HELP-TEC/MQTT_Keypad/board/Datasheet/demo_board/ESP32-POE-ISO-GPIO.png

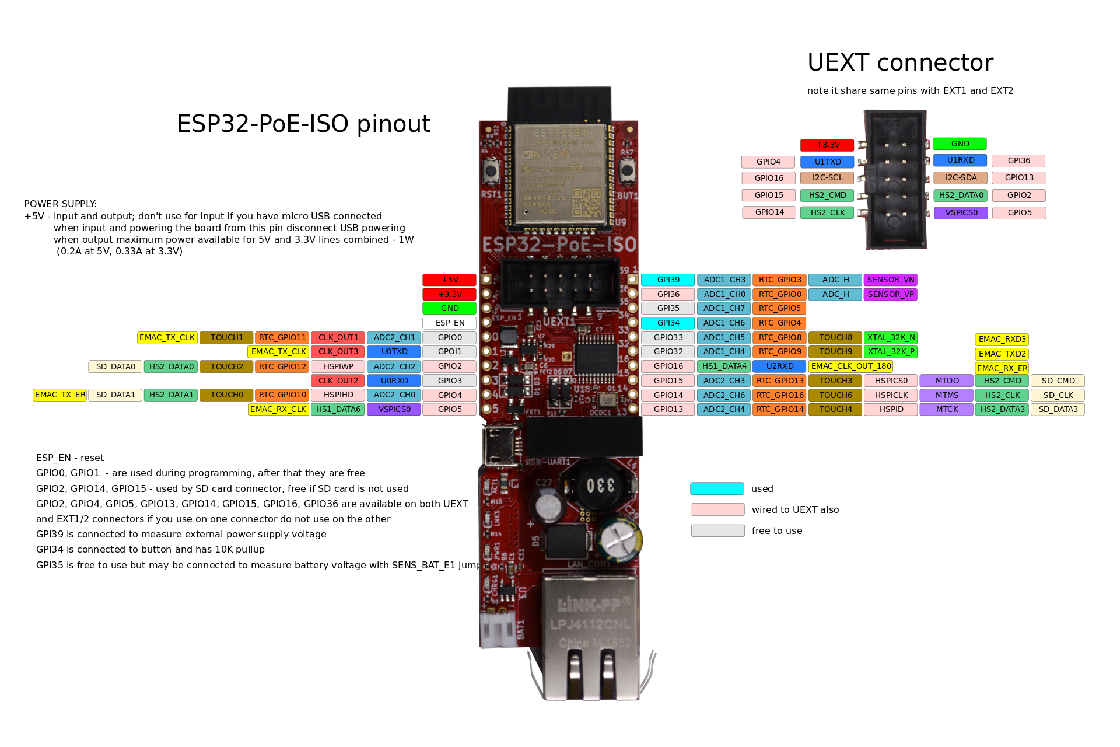
board/Datasheet/demo_board/ESP32-POE-ISO-GPIO.png
