HELP-TEC/MQTT_Keypad/README.md

# MQTT_Keypad
Keypad board using MQTT to transmit its signals

KiCAD  6.0.2 (version CERN Windows)
