HELP-TEC/MQTT_Keypad/Consception/Hardware.docx

Hes-so,HelpTec

Développement architecture Hardware

Document de spécification architecturale hardware générique niveaux d’abstraction élevé

Thibault Sampiemon

[Date]

# Architecture Carte de Gestion des Périphériques :

button

button

button

button

button

button

button

button

button

button

button

button

button

button

button

Ethernet

POE transformer

Ethernet connector

DC/DC converter

microcontroler

AC/DC adapter

potentiomètre

I/O schield

Bouttons

Bouttons

# Architecture Carte de Gestion des Périphériques :
