HELP-TEC/MQTT_Keypad/Consception/Doc1.docx

# SPI :

Le seul spi accessible facilement est le même que pour la carte mémoire.

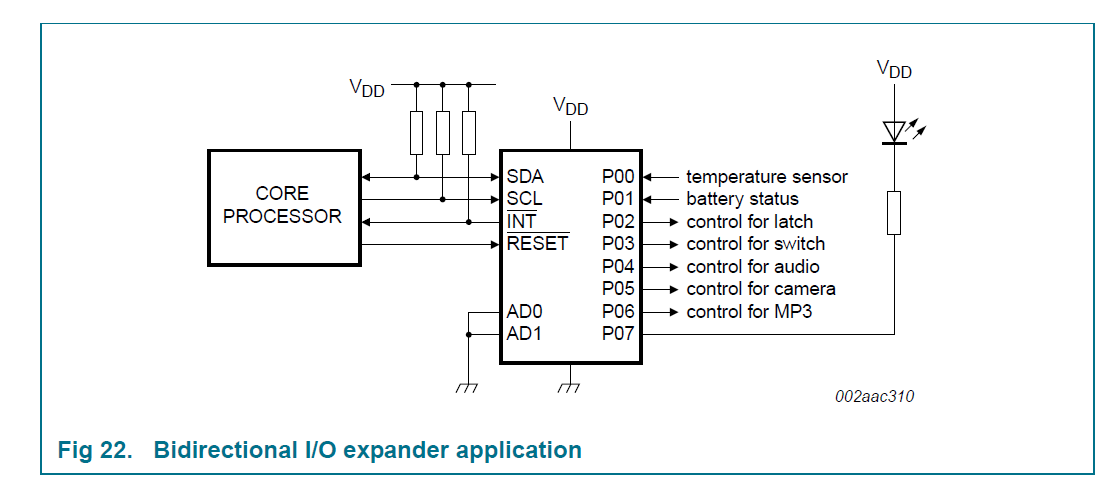
[picture p2: figure]
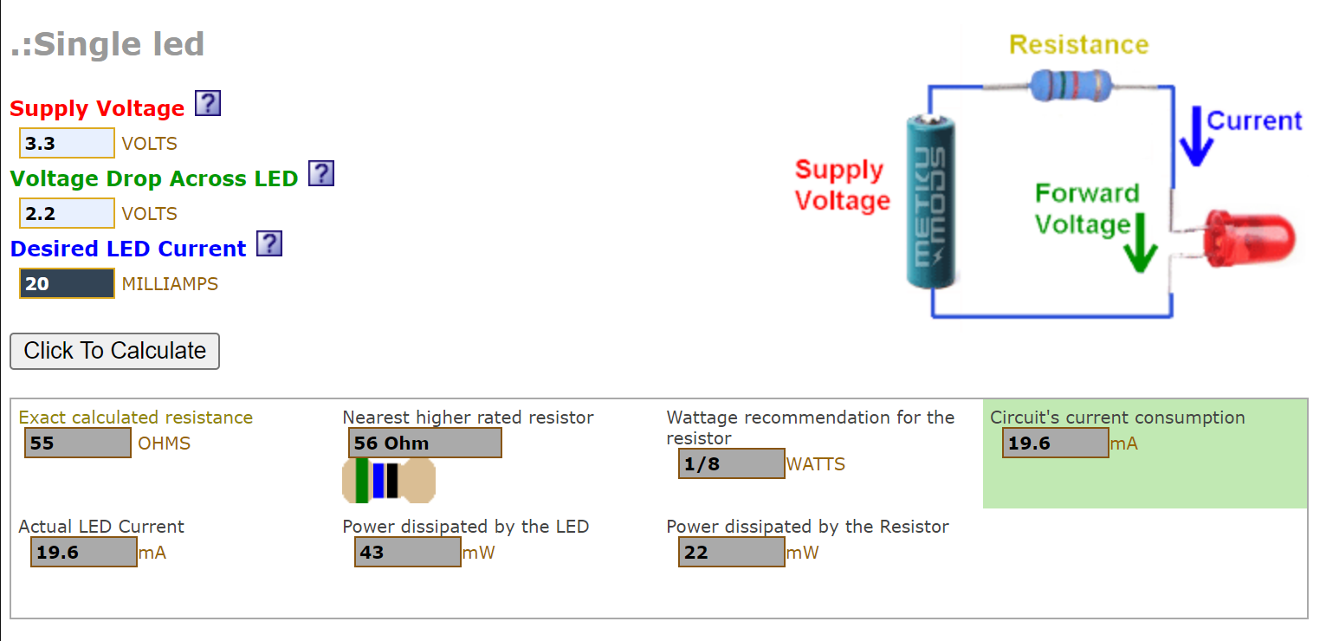
[picture p3: figure]
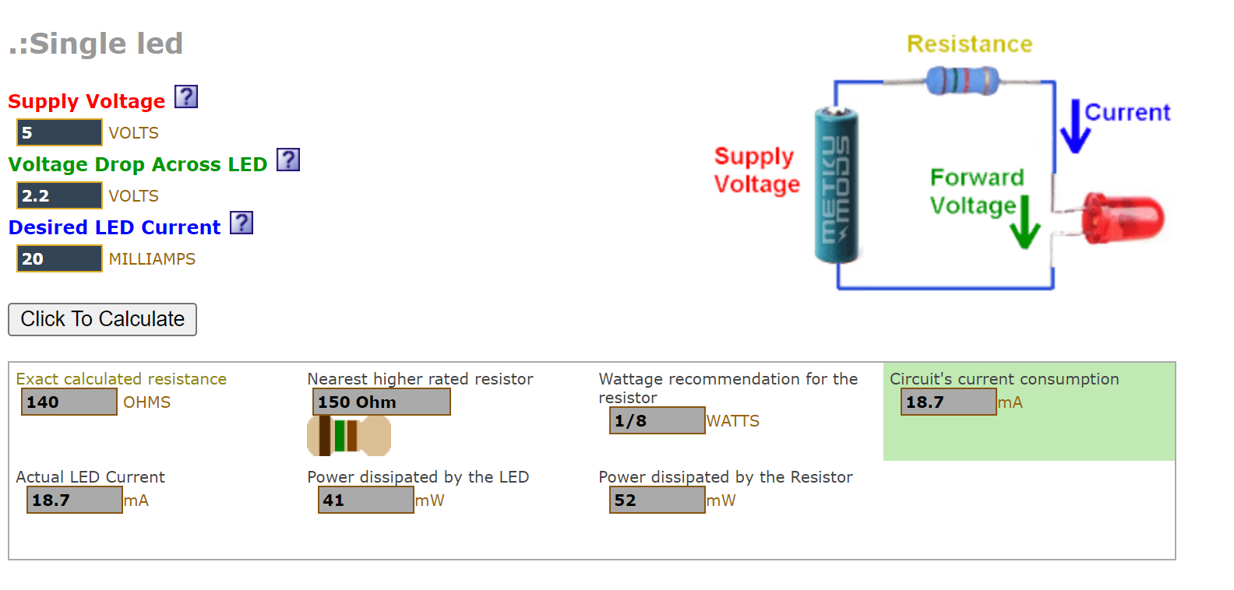
[picture p4: figure]
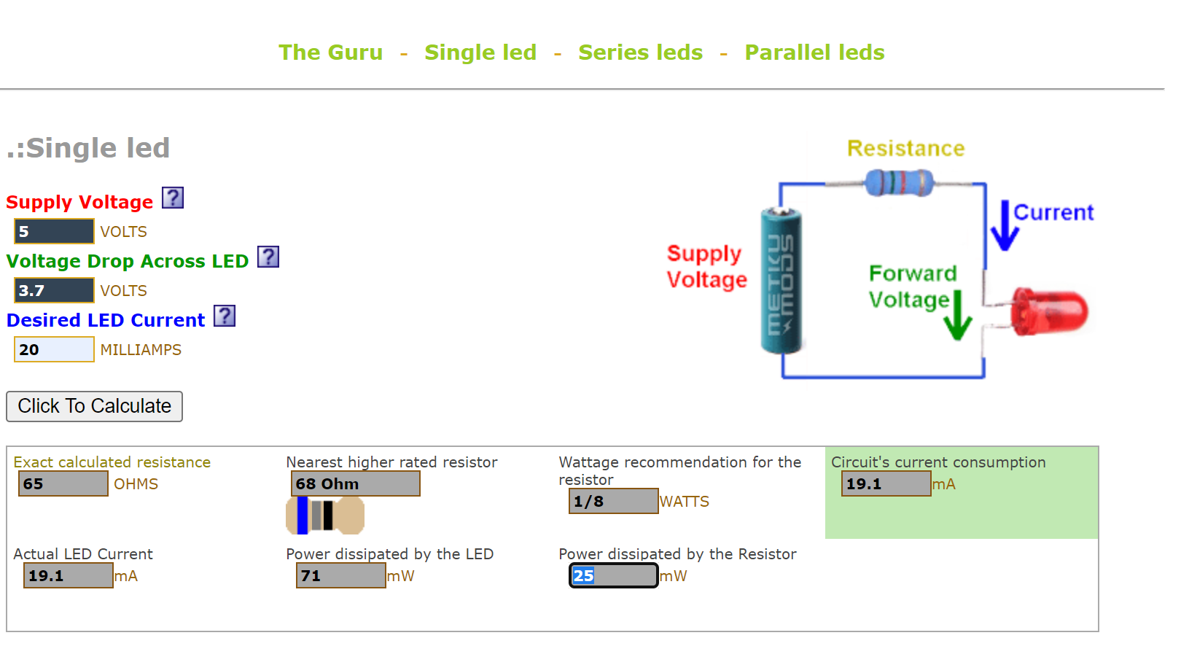
[picture p5: figure]
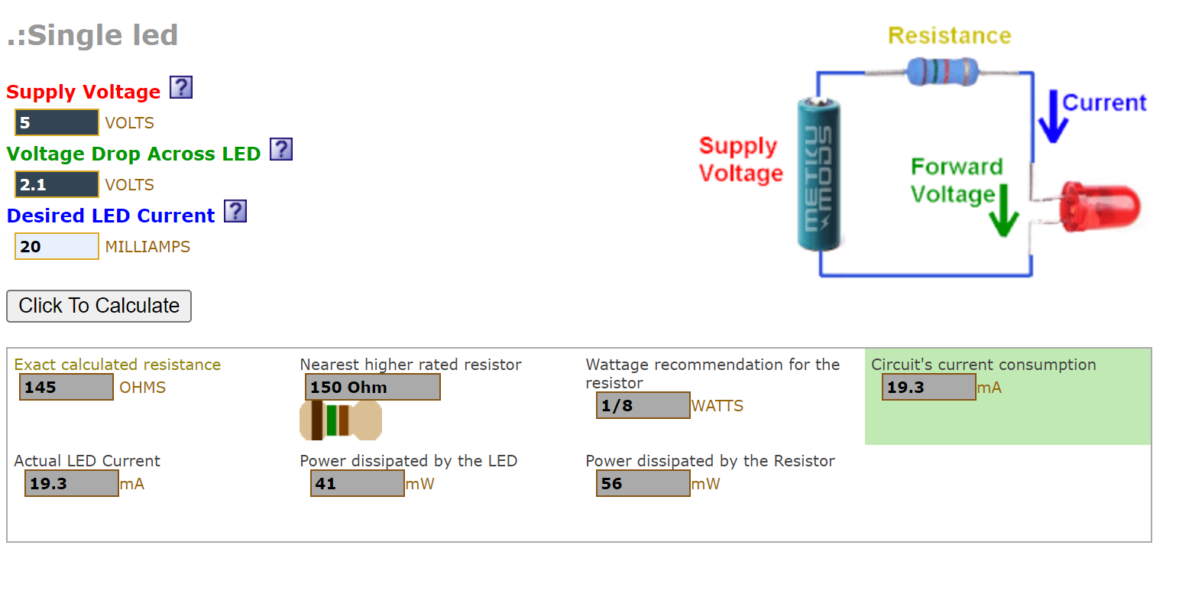
[picture p6: figure]
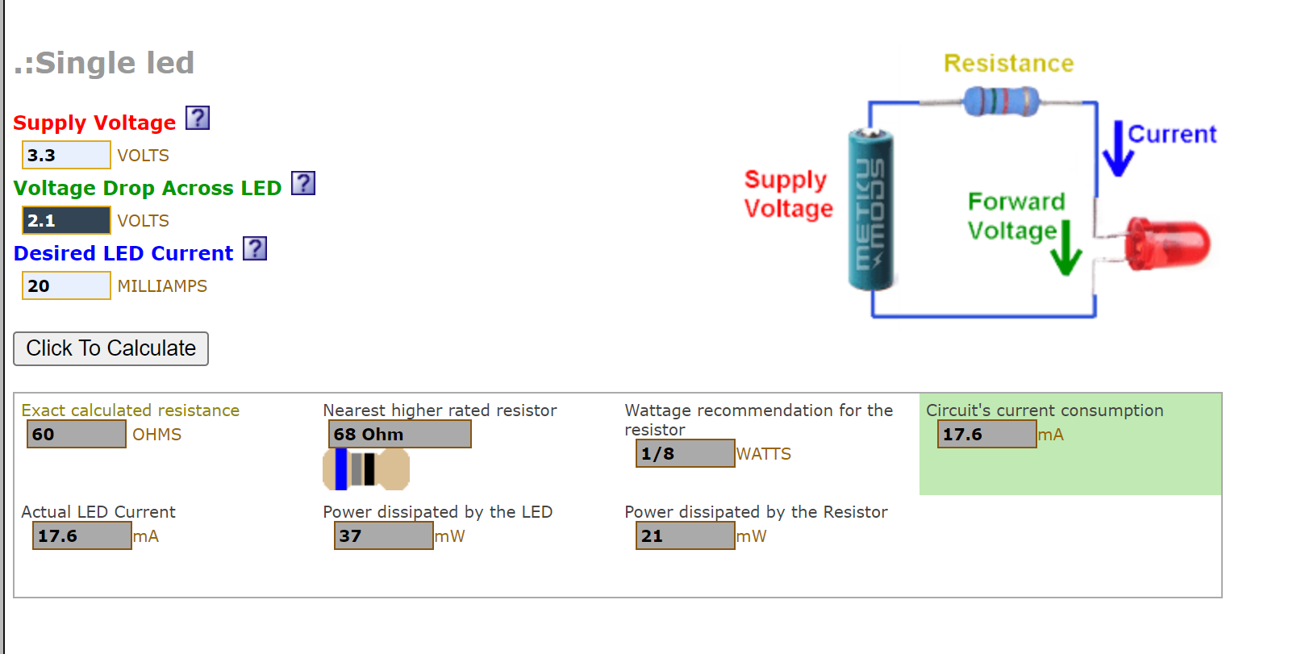
[picture p7: figure]
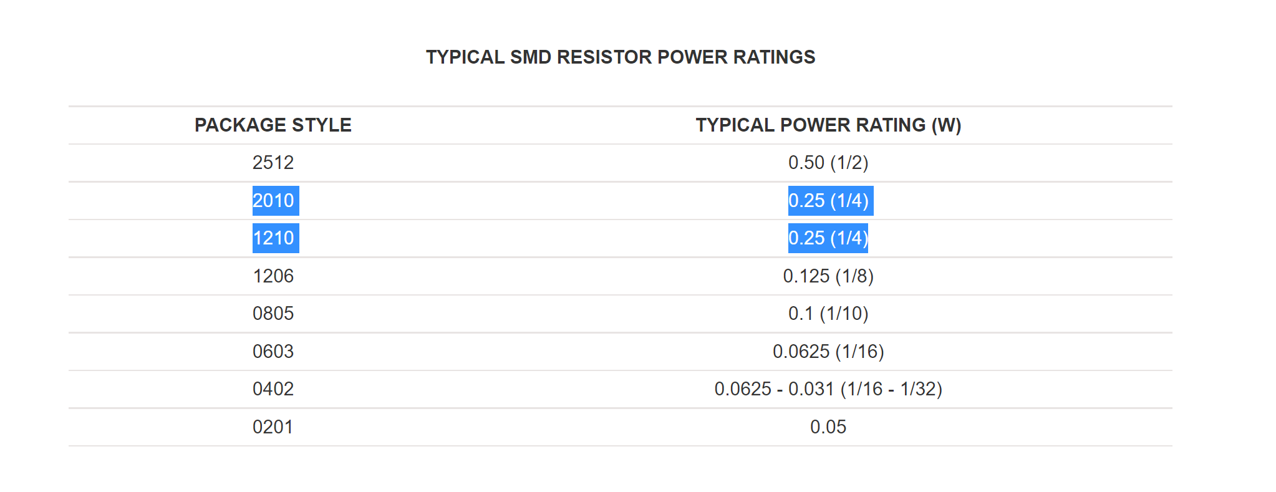
[picture p8: figure]
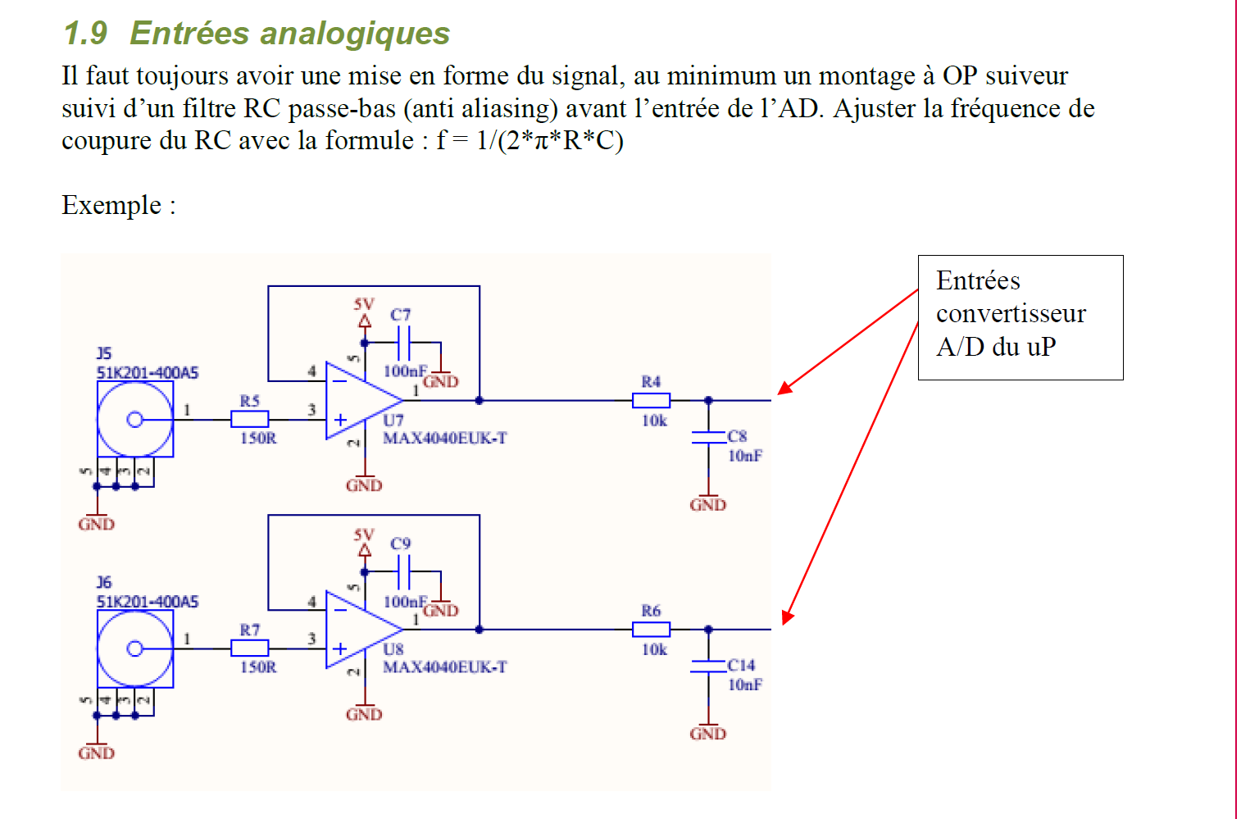
[picture p9: figure]

Avec 100 nf 1000hz (jamais de mesure plus fréquente que 1ms)

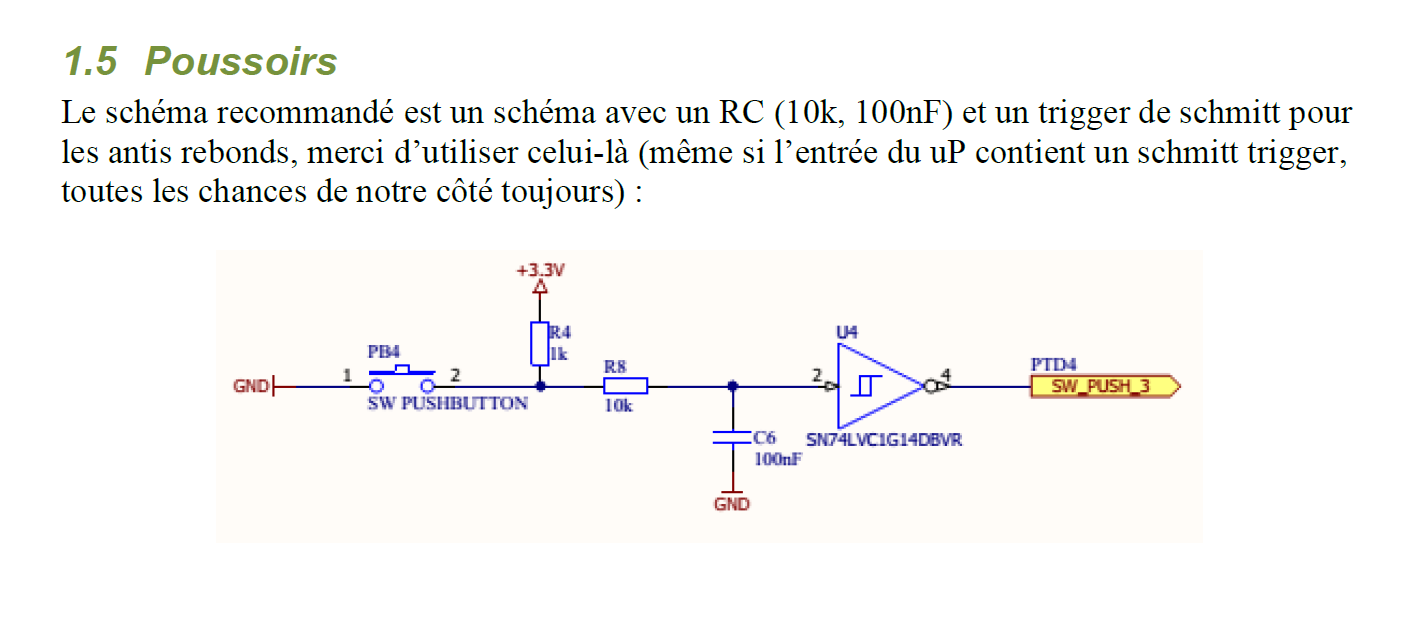
[picture p10: figure]
