HELP-TEC/MQTT_Keypad/doc pcb cours/Eléments schématiques de base V4.2.pdf

Projet P2

___________________________________________________________________________

Serge Monnerat | Page 1

## Eléments schématiques de base

___________________________________________________________________________

### Table des matières

___________________________________________________________________________

### 1.1 Points de mesure

D’une manière générale il faut prévoir des points de mesure permettant de mesurer facilement les éléments sensibles de votre système, on pense ici au bus I2C, SPI, UART, etc…
Au niveau de l’alimentation il faut aussi prévoir un point « d’injection » d’une alimentation externe au cas où votre alimentation disfonctionne.

### 1.2 Connecteur JTAG

Vérifiez votre connecteur JTAG, s’il est faux impossible de programmer le uP ! Le connecteur ci-dessous est compatible avec le boitier JTAG Pe-Micro que l’on utilise. Exemple JTAG d’un Cortex M0+ (KLxx chez Freescale ) :

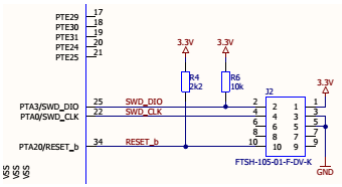
[picture p51: figure]

Exemple JTAG d’un Cortex M4 (MKxx chez Freescale) :

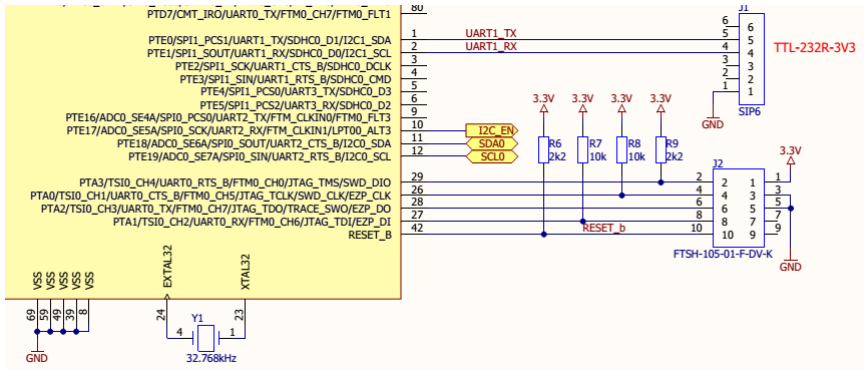
[picture p52: figure]

___________________________________________________________________________

### 1.3 Quartz externe

Dans l’absolu le quartz interne peut être utilisé avec les uP Kinetis, mais l’on met tous les atouts de notre côté, on prévoit aussi un quartz externe, quitte à ne pas souder les composants, mais au moins nous avons une alternative, c’est un prototype pas un produit fini ! Pas de clock CPU = rien ne fonctionne !

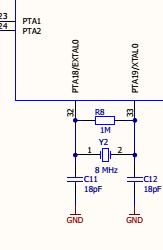
[picture p53: figure]

### 1.4 Alim de la partie analogique (ADC) et de la référence de tension de l’ADC

- Plusieurs cas de figure se présentent. Pour une précision moyenne 10/12 bits :

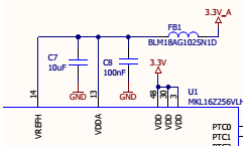
[picture p54: figure]

La ferrite de bead se comporte comme une résistance, mais sans la chute de tension et supprime le bruit haute fréquence ! Ce schéma est le schéma classique passe-partout. En principe on utilise un régulateur 3.3V linéaire uniquement pour cette alimentation. Mettre les condensateurs et la ferrite proches des pattes !
- Si la précision est vraiment secondaire, on peut omettre la ferrite et mettre deux condensateurs de 100nF sur VREFH et VDDA → tout prêt des pattes !

___________________________________________________________________________
- Si la précision doit être importante, il faut utiliser une référence de tension externe (par exemple http://www.ti.com/lit/ds/symlink/tl431.pdf ) sur VREFH et alimenter VDDA comme ci-dessus.

Dans tous les cas il faut un régulateur linéaire pour le 3.3V analogique et pas un switching !

### 1.5 Poussoirs

Le schéma recommandé est un schéma avec un RC (10k, 100nF) et un trigger de schmitt pour les antis rebonds, merci d’utiliser celui-là (même si l’entrée du uP contient un schmitt trigger, toutes les chances de notre côté toujours) :

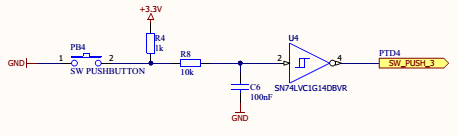
[picture p55: figure]

### 1.6 Pullups

La pullup est un savant mélange entre consommation et immunité au bruit !
La pullup de 10k est la pullup qui fonctionnera toujours ! Elle consomme 330uA sous 3.3V. On dit qu’un courant de 1 à 2mA est difficilement perturbable, donc sur une pin reset il faut mettre une résistance de 2k2 (courant 1.5mA), le courant est plus grand, mais le reset est actionné rarement, le pic de consommation n’est donc pas grave et l’immunité au bruit est garantie (ce serait bête d’avoir le reset sensible au bruit !).
Pour une entrée actionnée plus souvent au peut augmenter la pullup de 10k à 56k ou 100k afin de moins consommer.

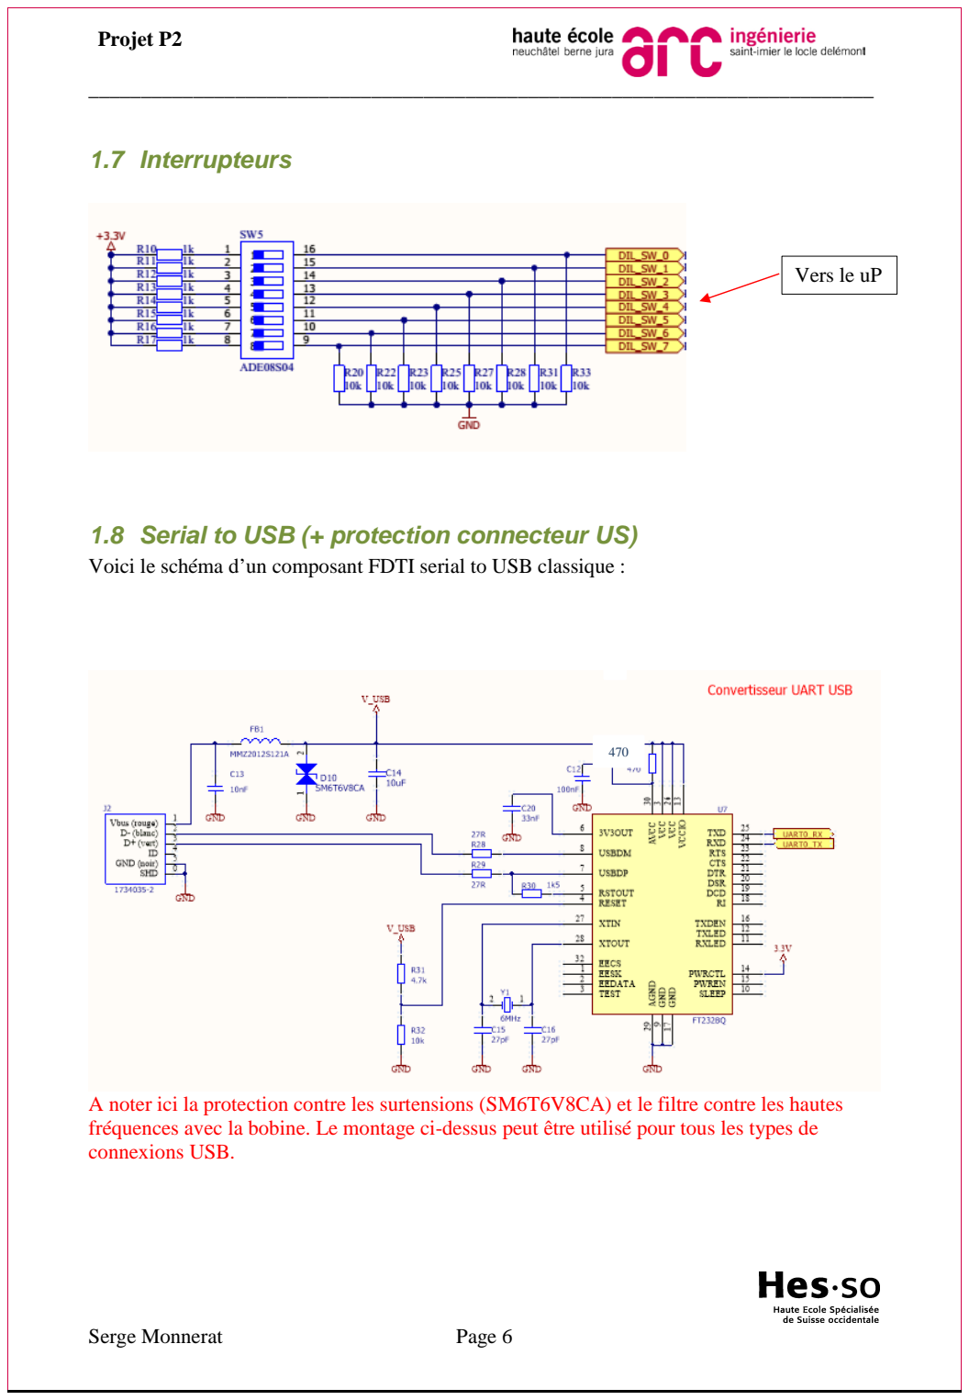
[picture p56: page 6]

___________________________________________________________________________

### 1.7 Interrupteurs

### 1.8 Serial to USB (+ protection connecteur US)

Voici le schéma d’un composant FDTI serial to USB classique :

A noter ici la protection contre les surtensions (SM6T6V8CA) et le filtre contre les hautes fréquences avec la bobine. Le montage ci-dessus peut être utilisé pour tous les types de connexions USB.

Vers le uP

470

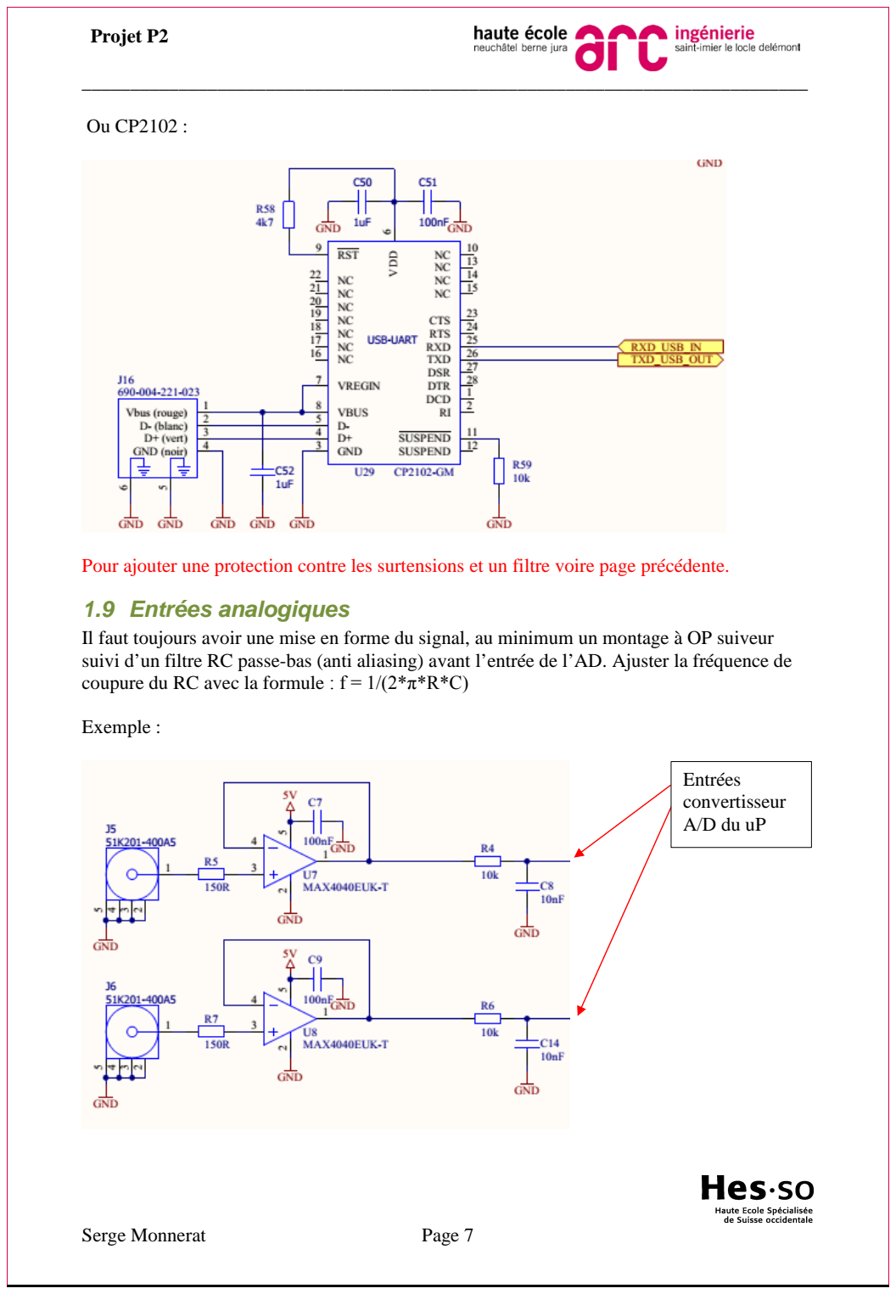
[picture p57: page 7]

___________________________________________________________________________ Ou CP2102 :

Pour ajouter une protection contre les surtensions et un filtre voire page précédente.

### 1.9 Entrées analogiques

Il faut toujours avoir une mise en forme du signal, au minimum un montage à OP suiveur suivi d’un filtre RC passe-bas (anti aliasing) avant l’entrée de l’AD. Ajuster la fréquence de coupure du RC avec la formule : f = 1/(2*π*R*C)
Exemple :

Entrées
convertisseur
A/D du uP

___________________________________________________________________________

### 1.10Entrées digitales

Comme pour un poussoir, mais évidemment sans (protection de la patte du uP et anti rebond) :

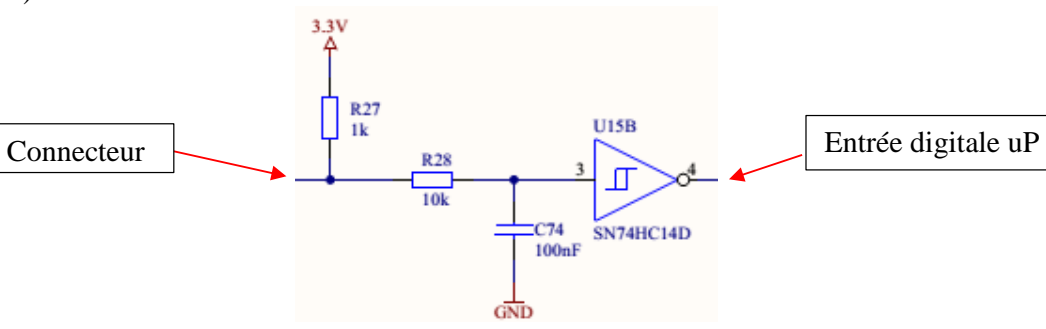
[picture p58: figure]
Connecteur; Entrée digitale uP

### 1.11Sorties digitales

Comme pour l’entrée, mais à l’envers, il faut toujours « driver » une sortie avec une porte, c’est elle qui casse en cas de problème et pas la patte du uP !

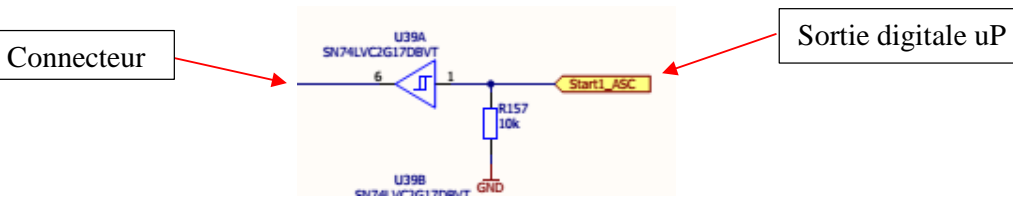
[picture p59: figure]
Connecteur; Sortie digitale uP

___________________________________________________________________________

### 1.12Drive d’un élément ayant besoin d’un courant plus élevé qu’une sortie CMOS

Les sorties d’un uP ne peuvent souvent pas « driver » un grand courant, on ajoute dans ce cas un MOS, dans tous les cas il faut vérifier dans le datasheet !
Cela peut-être une LED, un relais, un buzzer, etc… :

On peut omettre le MOS (pas conseillé) dans le cas d’un microcontrôleur pouvant délivrer assez de courant et/ou d’une LED basse consommation.
Par-exemple le courant max d’une pin du KL46 (attention au courant max total simultané) :

Sortie digitale uP

Courant max single pin low drive et high drive (config software) en fonction de
VDD

Courant max
simultané

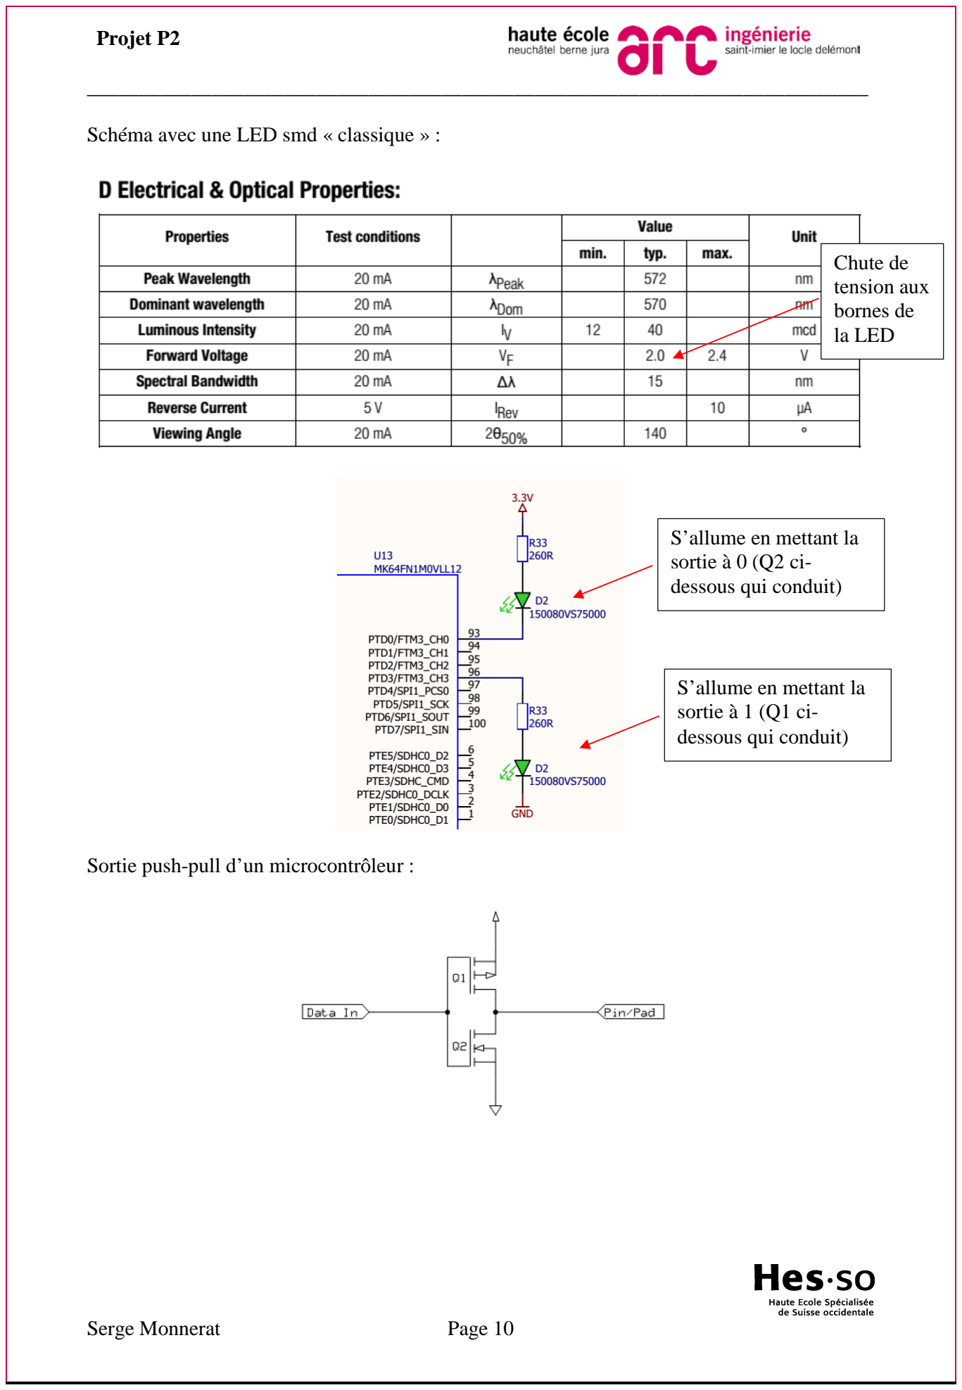
[picture p60: page 10]

___________________________________________________________________________ Schéma avec une LED smd « classique » :

Sortie push-pull d’un microcontrôleur :

Chute de
tension aux
bornes de
la LED

S’allume en mettant la
sortie à 0 (Q2 ci-dessous qui conduit)

S’allume en mettant la
sortie à 1 (Q1 ci-dessous qui conduit)

___________________________________________________________________________ Calcul du courant : I = (3.3V-2V)/260Ω = 5mA, ce qui correspond à une luminosité de 10mcd, ce qui est une luminosité normale.

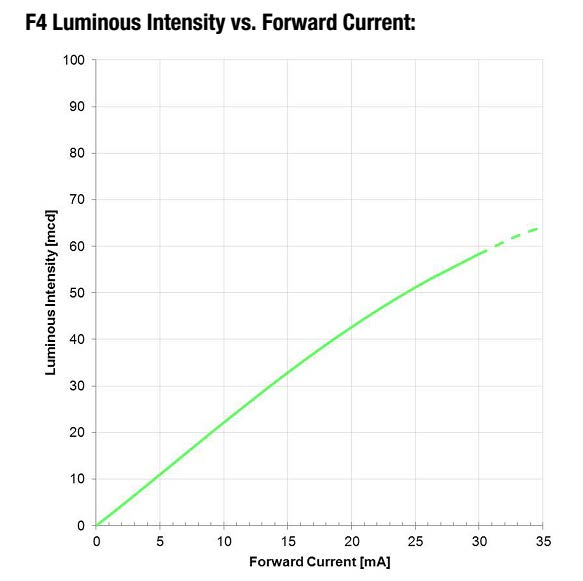
[picture p61: figure]

### 1.13Sorties analogiques

De nouveau on protège la sortie analogique avec un suiveur :

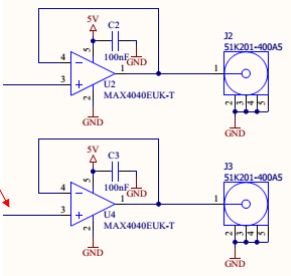
[picture p62: figure]

Sortie analogique uP
ou convertisseur DA

___________________________________________________________________________

### 1.14Condensateurs de découplage

On doit connecter à chaque pin d’alimentation de chaque circuit un condensateur de découplage dont la valeur est spécifiée dans le datasheet, sans mention particulière on choisira un condensateur de 100nF. Pour un microcontrôleur il y a plusieurs pins d’alimentation et cela se dessine en principe comme cela :

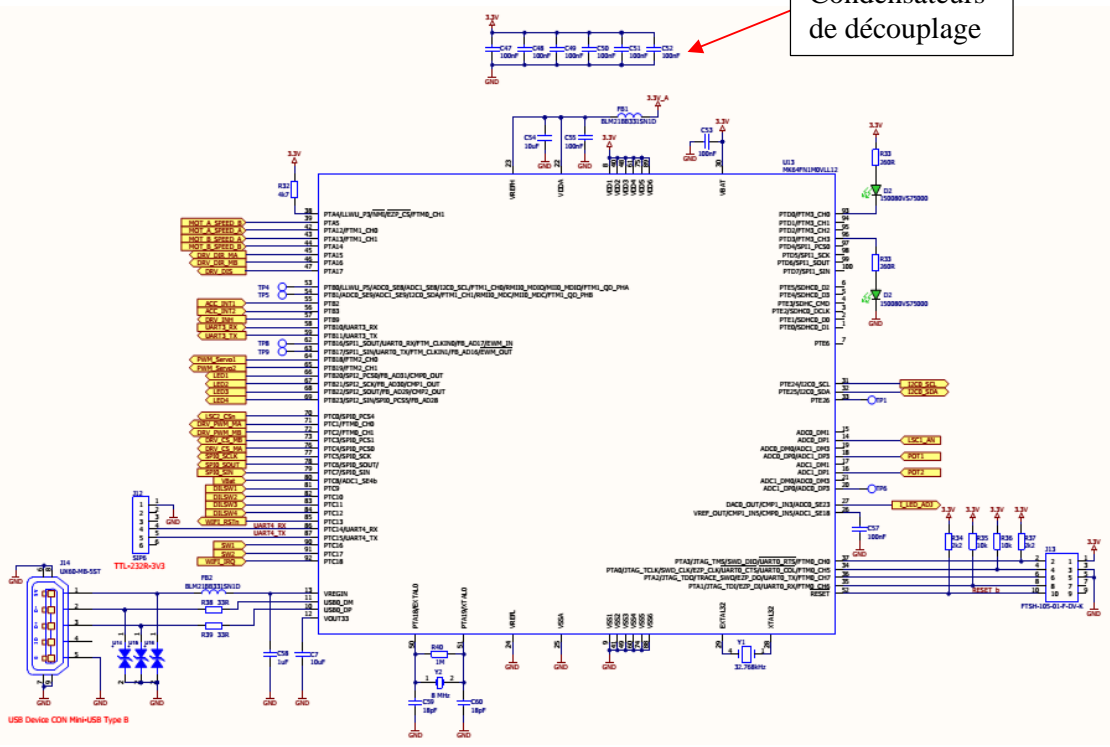
[picture p63: figure]
de découplage

- Au routage il faut que ces condensateurs soient le plus proches des pins d’alimentation !

Condensateurs

___________________________________________________________________________

### 1.15Convertisseur de niveau (Level shifter)

Il est parfois nécessaire de devoir convertir des signaux d’une tension vers une autre. Par exemple un microcontrôleur alimenté en 3.3V doit dialoguer par I2C avec un capteur supportant uniquement une alimentation en 5V. Dans ce cas il faut une conversion de tension de 3.3V vers 5V et vice versa. Il existe des IC qui font le travail :

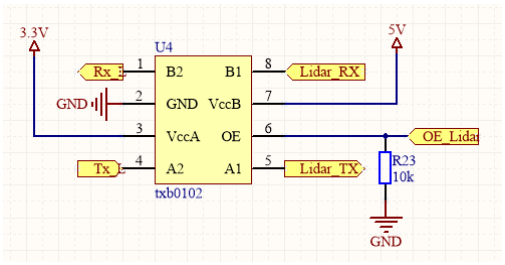
[picture p64: figure]

Chez TI on trouve une page permettant de sélectionner le produit désiré (nombre de canaux, tension, etc…) : http://www.ti.com/logic-circuit/voltage-level-translation/overview.html
A noter que certains circuits sont « auto-bidirectionnels », c’est-à-dire qu’ils configurent leurs pattes automatiquement en entrée ou en sortie, pratique dans le cas de l’I2C car la patte SDA doit être bidirectionnelle ! Attention pour l’I2C (open drain) prendre dans la série LSF01xx (TI), ou vérifier que le circuit soit compatible avec des lignes open drain.

___________________________________________________________________________

### 1.16Isolation d’une batterie en charge et alimentation

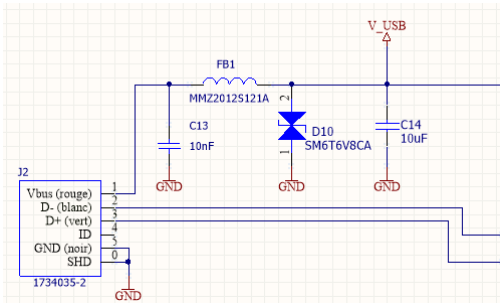
[picture p65: figure]
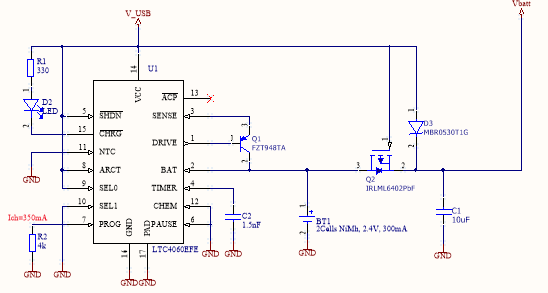
[picture p66: figure]

Lorsque l’USB fournit l’alimentation (5V) le chargeur est en fonction et charge la batterie BT1. Si dans le même temps on alimente la carte électronique avec cette batterie BT1 on perturbe la charge. Pour éviter ce cas de figure on insert le MOS Q2 qui est ouvert lorsque l’USB est branché (ce qui isole la batterie du reste du circuit) et fermé dans le cas contraire ce qui permet à la batterie d’alimenter la carte. Lorsque Q2 est ouvert la carte est alimentée par l’USB à travers la Schottky (chute de tension plus basse qu’une diode normale : 0.2V). Cette diode empêche le retour de la tension batterie vers l’alim USB.
Il faut donc prévoir pour l’alimentation des DC-DC (à la suite Vbatt) une plage de tension qui peut variée de la tension batterie minimale (ici 1.8V) jusqu’à la tension USB de max 5.5V.

___________________________________________________________________________ Les fabricants d’IC ont prévu sur leur site internet des « facilitateurs » de dimensionnement d’alimentations, comme chez TI : https://webench.ti.com/webench5/power/webench5.cgi?origin=ti_panel&app=powerarchitect&lang_chosen=en_US (https://webench.ti.com/webench5/power/webench5.cgi?origin=ti_panel&app=powerarchitect&lang_chosen=en_US)

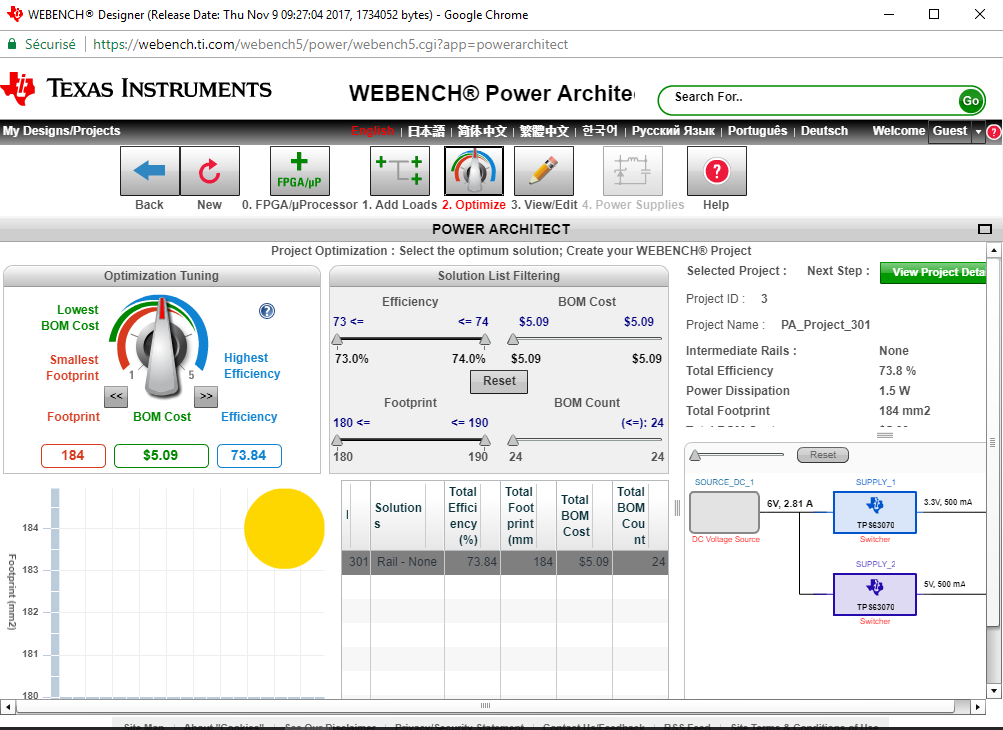
[picture p67: figure]

___________________________________________________________________________ Ou chez LINEAR :
http://www.linear.com/solutions/

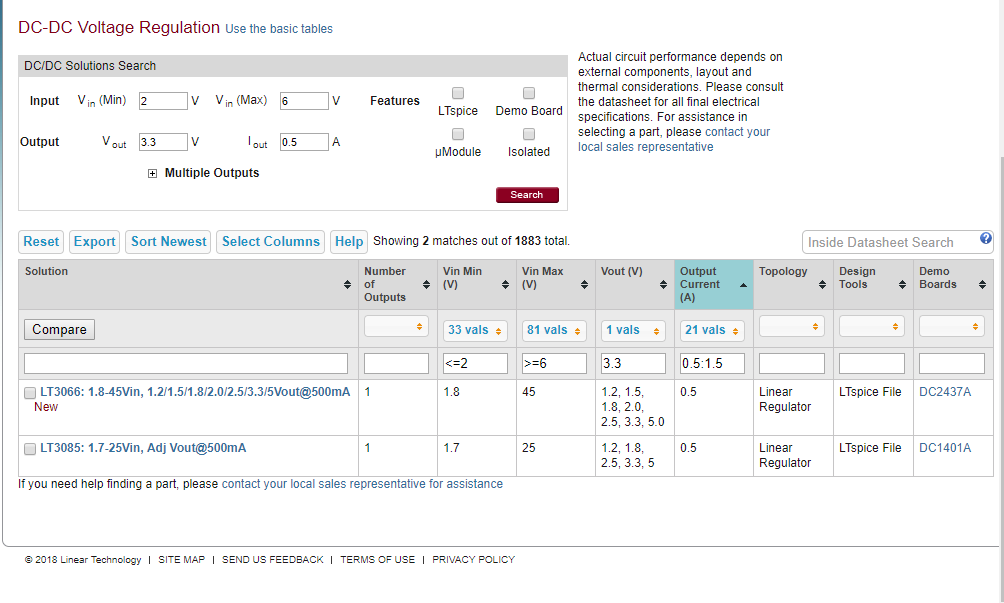
[picture p68: figure]

___________________________________________________________________________

### 1.17ON/OFF de l’alimentation d’un circuit ou d’un capteur

Une sortie d’un microcontrôleur et un ou deux transistors MOS permettent de switcher les alimentations des circuits ou capteurs externes au microcontrôleur, par exemple afin d’économiser de l’énergie :

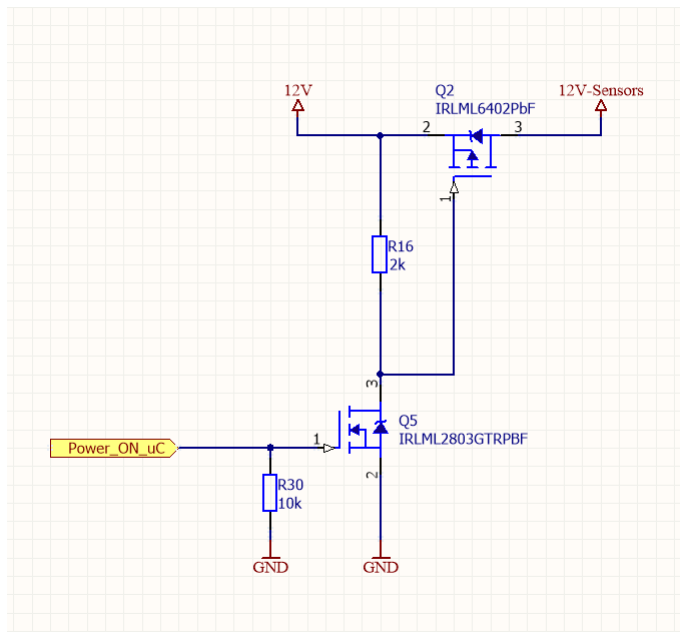
[picture p69: figure]

- Q5 est un MOS N, c’est-à-dire qu’il conduit quand la tension Vgs est positive (Gate pin1 et Source pin2), donc s’il y a 3.3V sur la Gate (sortie digitale du microcontrôleur à 1) cela nous fait 3.3V et Q5 conduit ce qui amène le 0V sur la Gate de Q2. Dans le cas contraire, Q5 ne conduit pas et l’on retrouve 12V par R16 sur la Gate de Q2.
- Q2 est MOS P, c’est-à-dire qu’il conduit quand la tension Vgs est négative (Gate pin1 et Source pin2), donc s’il y a 0V sur la Gate cela nous fait -12V et Q2 conduit, les circuits alimentés par le « 12V-sensors » sont ON.
- Pourquoi faut-il 2 MOS ? Si l’on doit « driver » une tension plus grande que la tension d’alim du microcontrôleur, par exemple 12V, il faut deux MOS, sinon on retrouve le 12V sur la sortie du microcontrôleur et boum. Si la tension à « driver » est la même que la tension du microcontrôleur seul Q2 suffit (mais ce sera un 0V qui fera que Q2 conduise). Attention choisir un MOS qui conduit suffisamment avec le 3.3 V comme le IRLML6401PbF.
- R16 est nécessaire afin de fixer un potentiel sur la Gate de Q2 lorsque Q5 est ouvert.
- Il faut vérifier les tensions Vgs max des MOS notamment pour Q2, idem pour le courant max Ids de Q2, qui doit-être supérieur à la somme des courants d’alimentation des circuits alimentés par « 12V-Sensors ».

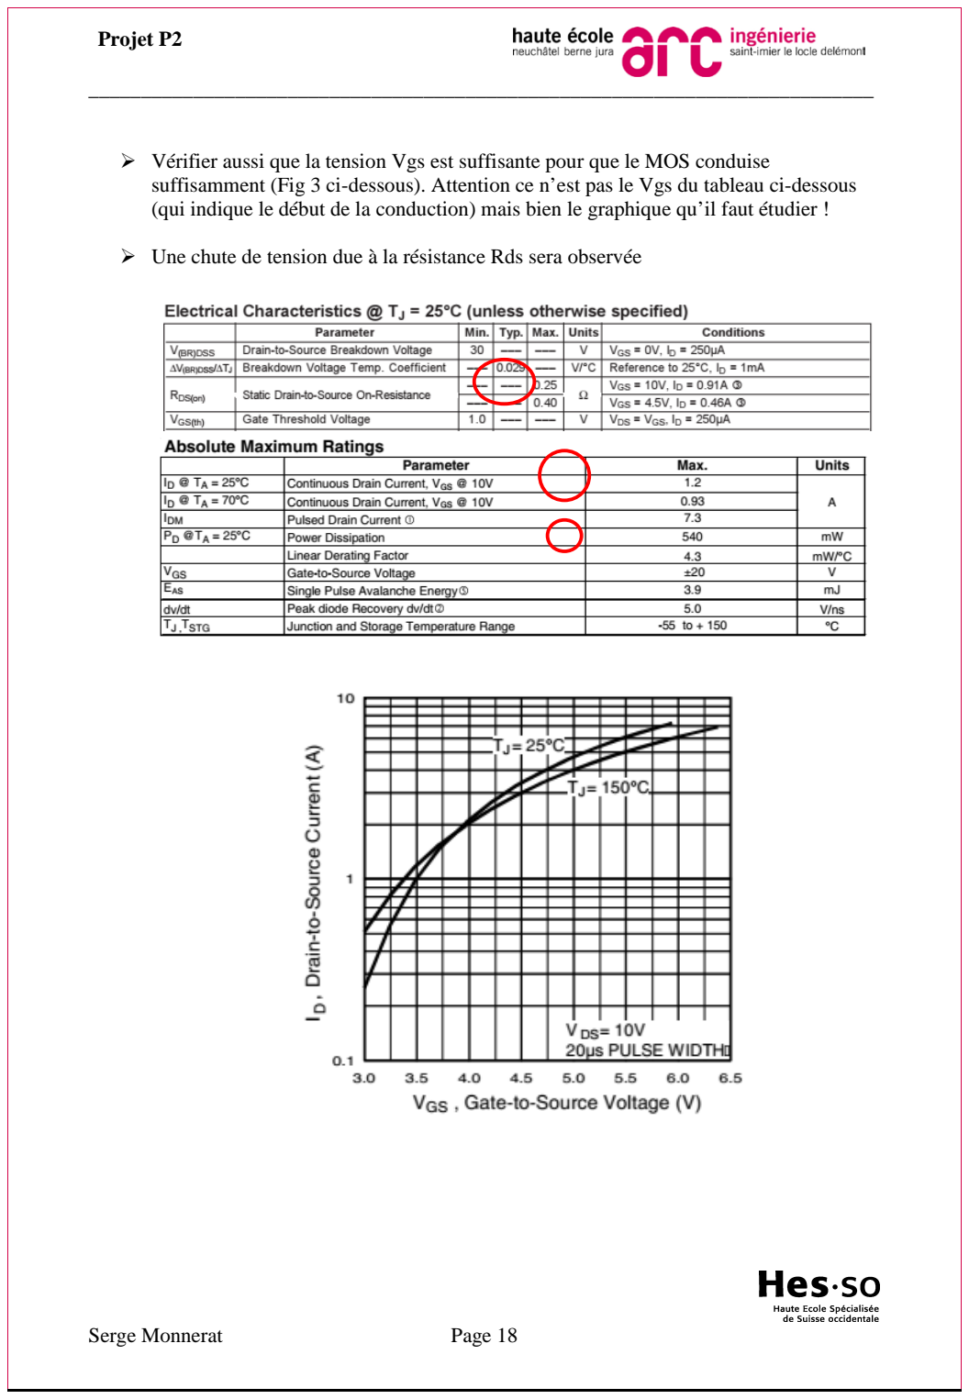
[picture p70: page 18]

___________________________________________________________________________

- Vérifier aussi que la tension Vgs est suffisante pour que le MOS conduise suffisamment (Fig 3 ci-dessous). Attention ce n’est pas le Vgs du tableau ci-dessous (qui indique le début de la conduction) mais bien le graphique qu’il faut étudier !
- Une chute de tension due à la résistance Rds sera observée

___________________________________________________________________________

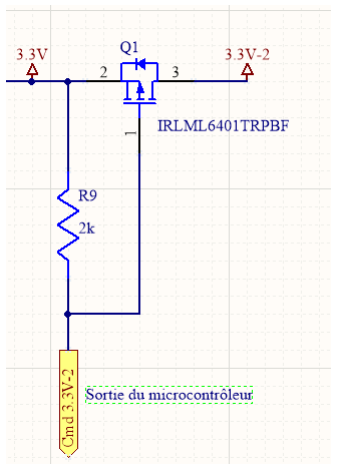
[picture p71: figure]

! Début de la conduction, pas utile ! IRLML6401 PbF :

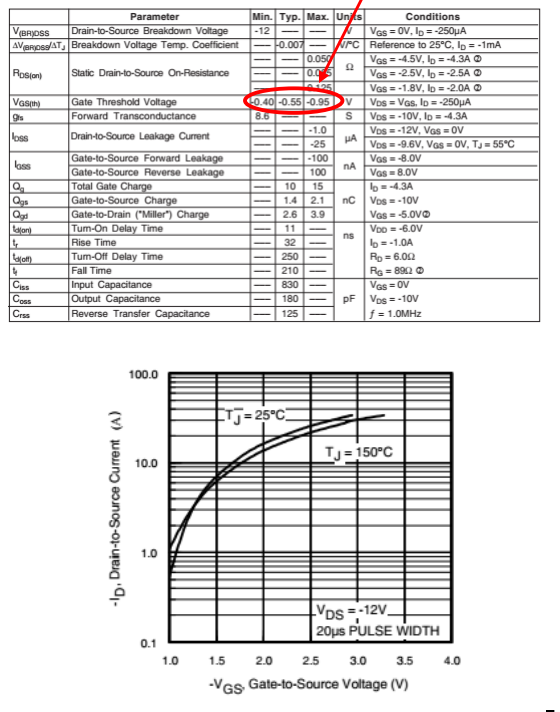
[picture p72: figure]

___________________________________________________________________________

### 1.18Protection contre le montage inversé d’une batterie

Par rapport au montage classique de protection consistant à insérer une diode en série dans l’alimentation, le montage ci-dessous à l’avantage de provoquer en fonctionnement normal, une chute de tension (UDS) d’alimentation bien inférieure à celle produite par une diode (VF).

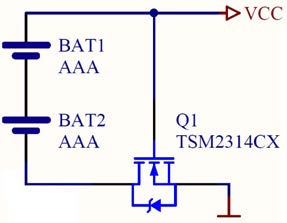
[picture p73: figure]
