HELP-TEC/MQTT_Keypad/doc pcb cours/Labo 1.pdf

Protocol SCTP | Labo1 | TEM

But

Prise en main du Protocol SCTP

Connaitre les différents paquets, les chunks etc

Travail demandé

Anaylser par wireshark la capture SCTP-ADDi.pcap

Rendre le diagramme en flèche entre l‘émetteur et le récepteur ainsi que le but de chaque paquet.

Commenter les chunks contenus dans les paquets.

Aide

Aip-SCTP.pdf de CISCO
