HELP-TEC/MQTT_Keypad/doc pcb cours/Labo 1 (1).pdf

Risk assessment Small business | Labo1 | TEM

But

Se familiariser avec les évaluations des risques selon ISO-27000 et comment les minimiser.

Travail demandé

Prendre un cas d’une entreprise et évaluer les risques, les failles et les menaces potentielles.

Rendre le fichier Excel avec les RISK ID identifiés et les évaluations (assessements)

Aide

Documents NIST
