HELP-TEC/MQTT_Keypad/board/ESP32-POE-ISO-master/ESP32-POE-ISO-master/HARDWARE/Dimensions/poe-iso-dimensions-2.png

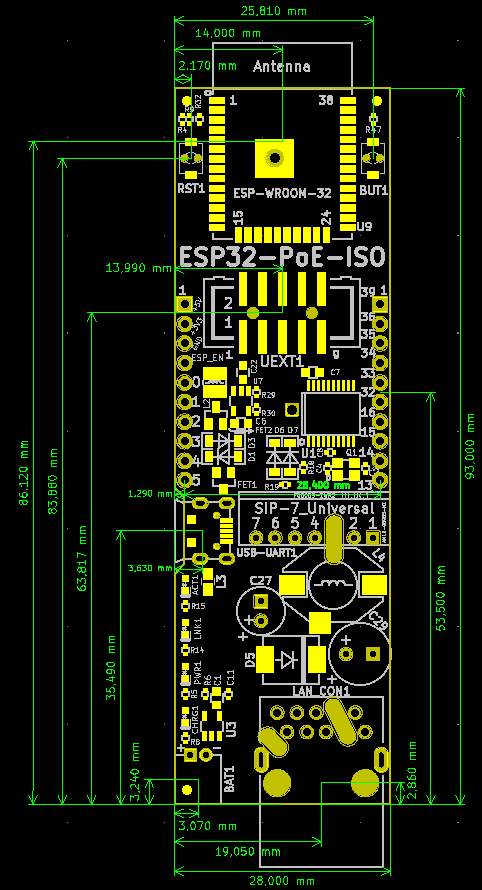
board/ESP32-POE-ISO-master/ESP32-POE-ISO-master/HARDWARE/Dimensions/poe-iso-dimensions-2.png
