HELP-TEC/MQTT_Keypad/board/Datasheet/Composants carte fille/C1608X5R1H104K080AA/C1608X5R1H104K080AA.step

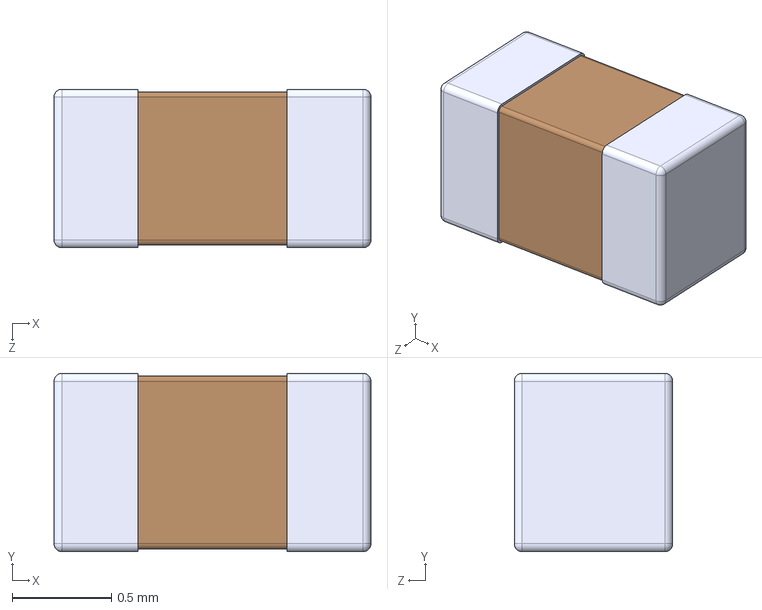
[picture p76: CAD file, 2022-03-15]
board/Datasheet/Composants carte fille/C1608X5R1H104K080AA/C1608X5R1H104K080AA.step
1.60 x 0.9 x 0.8 mm
