HELP-TEC/MQTT_Keypad/board/Datasheet/Composants carte fille/SN74LVC2G14DBVTG4/SN74LVC2G14DBVTG4.step

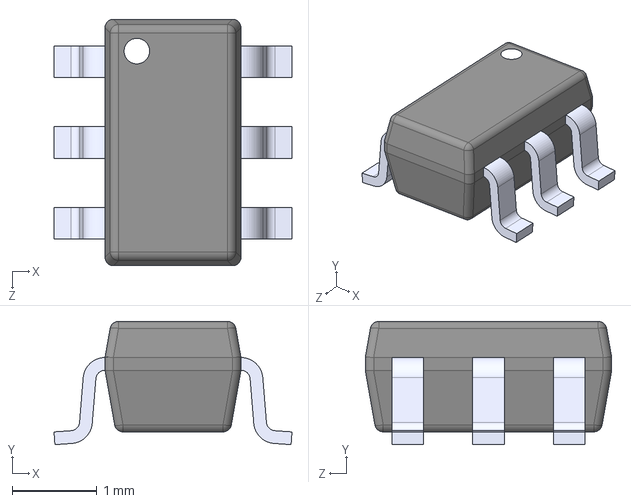
[picture p77: CAD file, 2022-03-15]
board/Datasheet/Composants carte fille/SN74LVC2G14DBVTG4/SN74LVC2G14DBVTG4.step
2.80 x 1.45 x 2.90 mm
