HELP-TEC/MQTT_Keypad/board/ESP32-POE-ISO-master/ESP32-POE-ISO-master/HARDWARE/ESP32-PoE-ISO-Rev.G1/3d/Cap_PTH_6_3x11x2_5mm.step

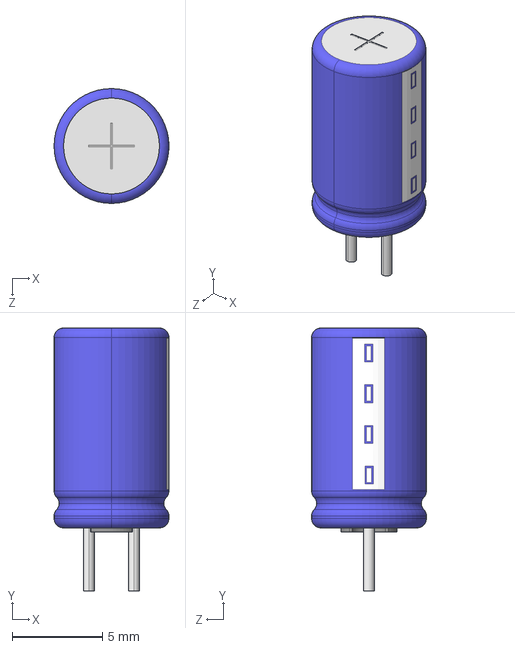
[picture p78: CAD file, 2022-03-15]
board/ESP32-POE-ISO-master/ESP32-POE-ISO-master/HARDWARE/ESP32-PoE-ISO-Rev.G1/3d/Cap_PTH_6_3x11x2_5mm.step
6.35 x 14.5 x 6.35 mm
