HELP-TEC/MQTT_Keypad/board/ESP32-POE-ISO-master/ESP32-POE-ISO-master/HARDWARE/ESP32-PoE-ISO-Rev.G1/3d/JST_B2B-PH-SM4-TB(DW02R).step

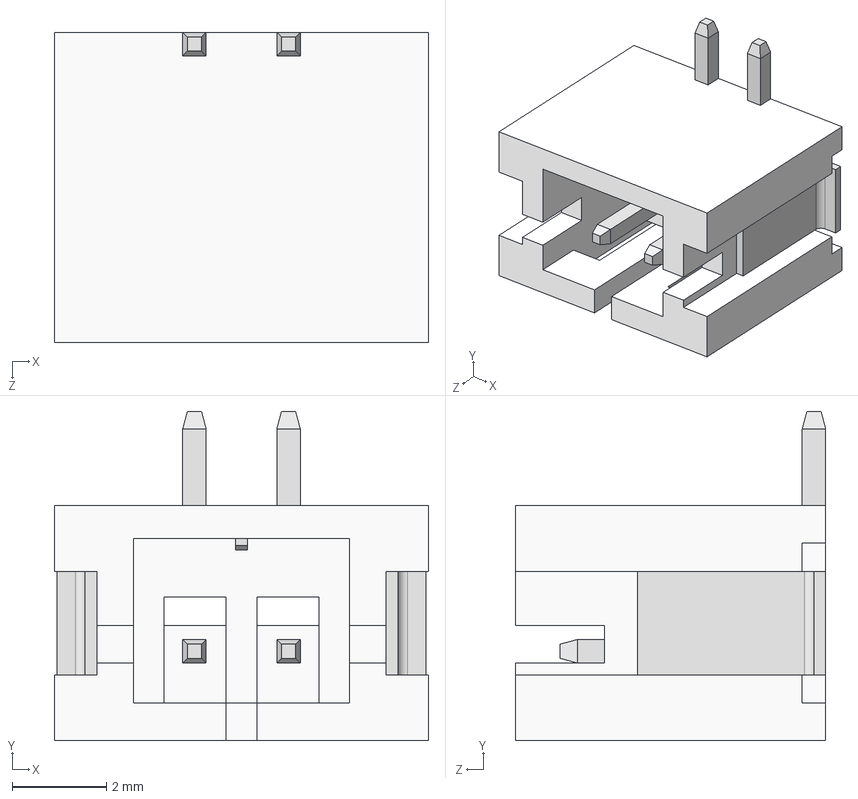
[picture p79: CAD file, 2022-03-15]
board/ESP32-POE-ISO-master/ESP32-POE-ISO-master/HARDWARE/ESP32-PoE-ISO-Rev.G1/3d/JST_B2B-PH-SM4-TB(DW02R).step
7.95 x 7.00 x 6.60 mm
