HELP-TEC/MQTT_Keypad/board/ESP32-POE-ISO-master/ESP32-POE-ISO-master/HARDWARE/ESP32-PoE-ISO-Rev.H/3d/SOD123.step

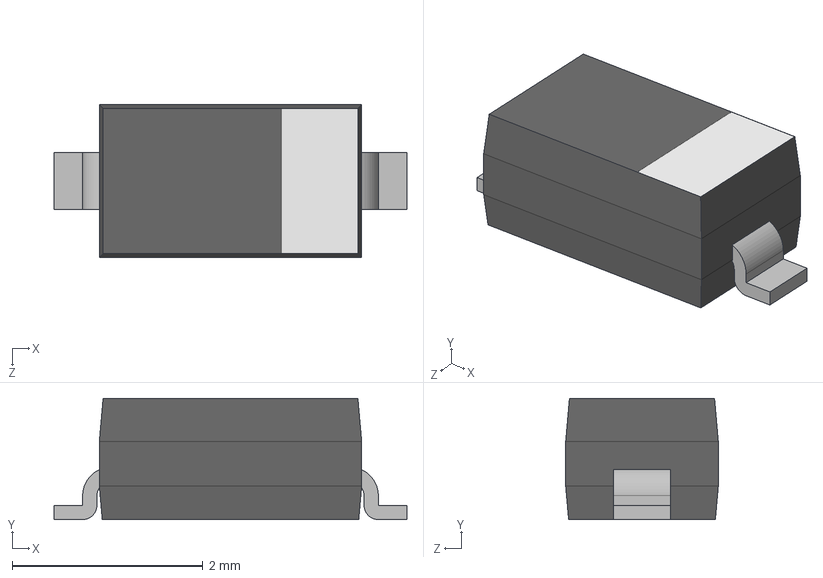
[picture p80: CAD file, 2022-03-15]
board/ESP32-POE-ISO-master/ESP32-POE-ISO-master/HARDWARE/ESP32-PoE-ISO-Rev.H/3d/SOD123.step
3.70 x 1.27 x 1.60 mm
