HELP-TEC/MQTT_Keypad/board/ESP32-POE-ISO-master/ESP32-POE-ISO-master/HARDWARE/ESP32-PoE-ISO-Rev.G1/3d/esp-wroom-32.step

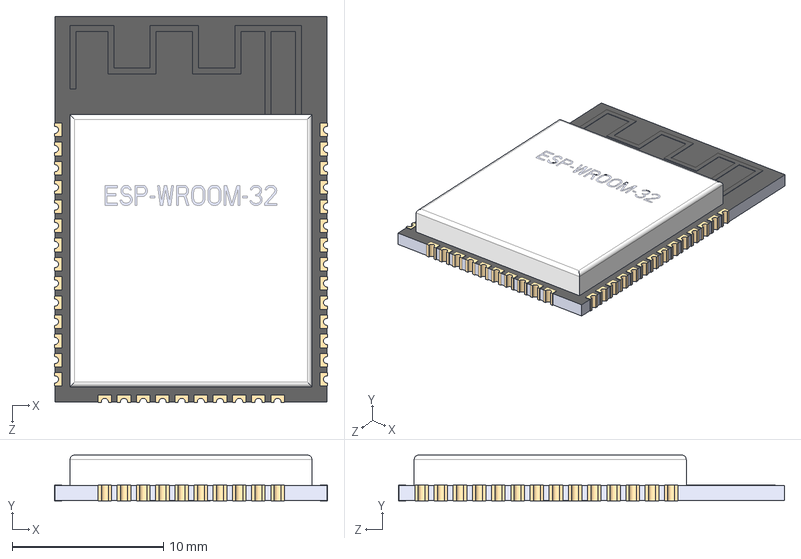
[picture p81: CAD file, 2022-03-15]
board/ESP32-POE-ISO-master/ESP32-POE-ISO-master/HARDWARE/ESP32-PoE-ISO-Rev.G1/3d/esp-wroom-32.step
18.1 x 3.04 x 25.5 mm
