HELP-TEC/MQTT_Keypad/board/ESP32-POE-ISO-master/ESP32-POE-ISO-master/HARDWARE/ESP32-PoE-ISO-Rev.H/3d/Micro_SD_card.step

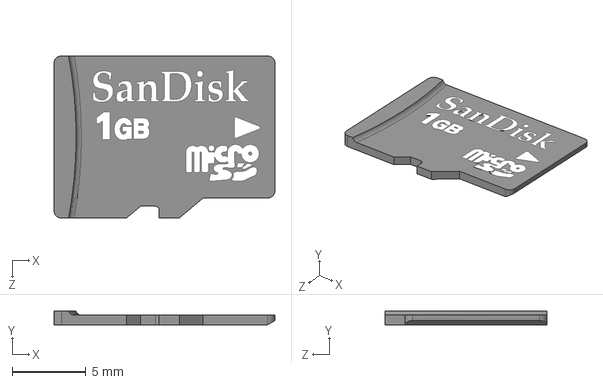
[picture p82: CAD file, 2022-03-15]
board/ESP32-POE-ISO-master/ESP32-POE-ISO-master/HARDWARE/ESP32-PoE-ISO-Rev.H/3d/Micro_SD_card.step
15.0 x 0.975 x 11.0 mm
