HELP-TEC/MQTT_Keypad/board/ESP32-POE-ISO-master/ESP32-POE-ISO-master/HARDWARE/ESP32-PoE-ISO-Rev.H/3d/SMD_Ceramic_Capacitors_1808(4520).step

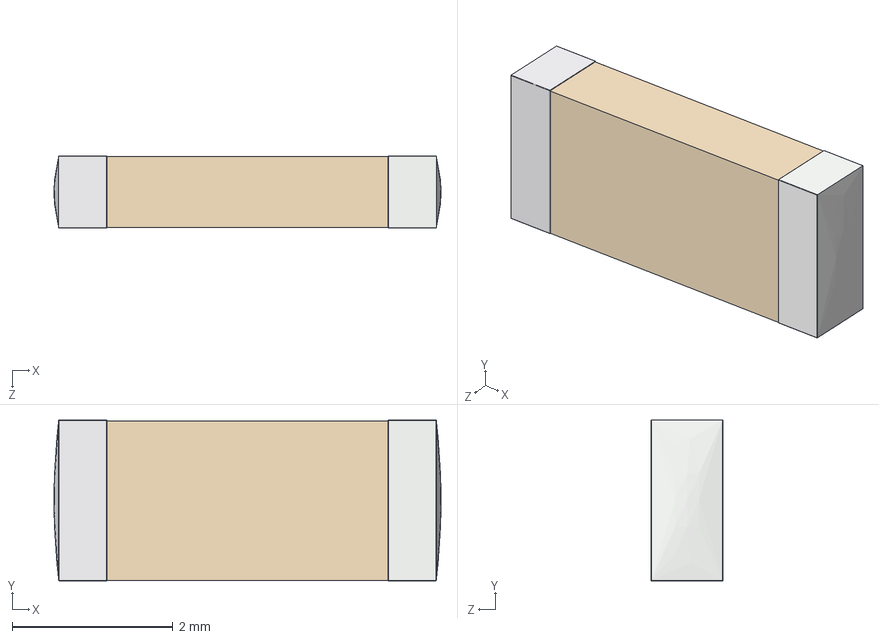
[picture p84: CAD file, 2022-03-15]
board/ESP32-POE-ISO-master/ESP32-POE-ISO-master/HARDWARE/ESP32-PoE-ISO-Rev.H/3d/SMD_Ceramic_Capacitors_1808(4520).step
4.82 x 2.00 x 0.9 mm
