HELP-TEC/MQTT_Keypad/board/ESP32-POE-ISO-master/ESP32-POE-ISO-master/HARDWARE/ESP32-PoE-ISO-Rev.H/3d/R_SMD 2512.STEP

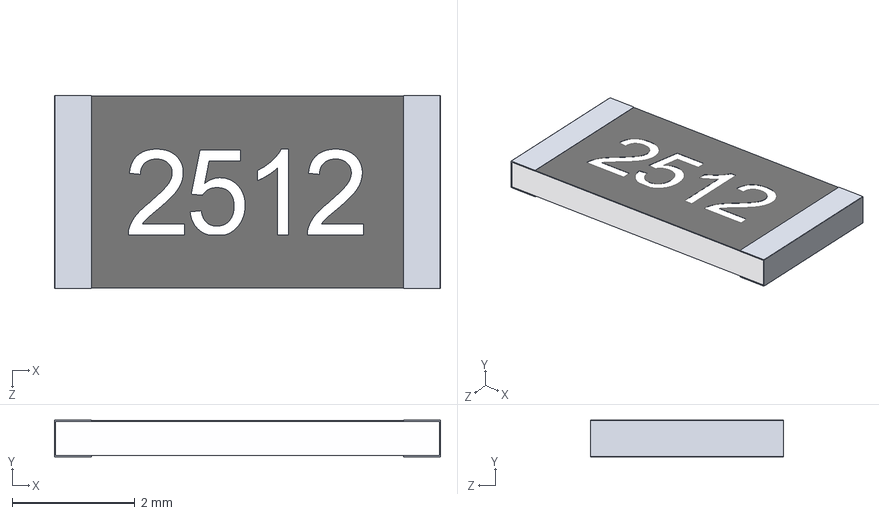
[picture p85: CAD file, 2022-03-15]
board/ESP32-POE-ISO-master/ESP32-POE-ISO-master/HARDWARE/ESP32-PoE-ISO-Rev.H/3d/R_SMD 2512.STEP
6.30 x 0.6 x 3.15 mm
2512 BODY
2512 PAD x 2
2512 OPIS
