HELP-TEC/MQTT_Keypad/board/ESP32-POE-ISO-master/ESP32-POE-ISO-master/HARDWARE/ESP32-PoE-ISO-Rev.H/3d/UEXT-SMD.STEP

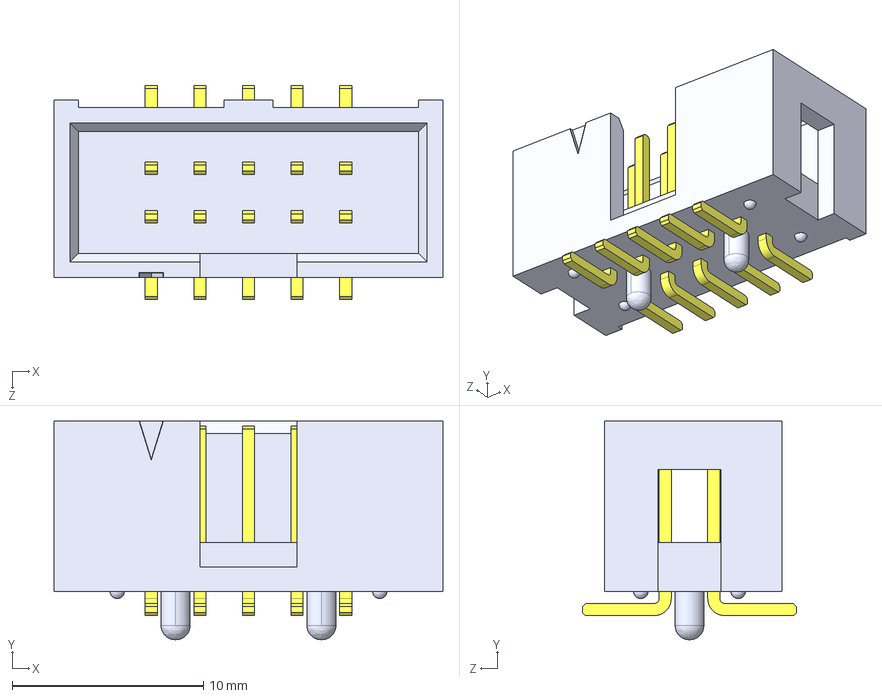
[picture p101: CAD file, 2022-03-15]
board/ESP32-POE-ISO-master/ESP32-POE-ISO-master/HARDWARE/ESP32-PoE-ISO-Rev.H/3d/UEXT-SMD.STEP
20.3 x 11.4 x 11.2 mm
User Library-HTST-105-01-F-DV-A__HTST-105-01-DV-A_header
User Library-HTST-105-01-F-DV-A__HTST-First_Position_Indicator
User Library-HTST-105-01-F-DV-A__T-1S6-05-01-DV_
