HELP-TEC/MQTT_Keypad/(list of files, cad)

Other CAD files:
board/ESP32-POE-ISO-master/ESP32-POE-ISO-master/HARDWARE/ESP32-PoE-ISO-Rev.B/3d/CD32_inductor.step
board/ESP32-POE-ISO-master/ESP32-POE-ISO-master/HARDWARE/ESP32-PoE-ISO-Rev.B/3d/Cap_8x11_5x3_5mm.step
board/ESP32-POE-ISO-master/ESP32-POE-ISO-master/HARDWARE/ESP32-PoE-ISO-Rev.B/3d/QFN-20_5x5x0_9mm.step
board/ESP32-POE-ISO-master/ESP32-POE-ISO-master/HARDWARE/ESP32-PoE-ISO-Rev.B/3d/RJ45_GB_LEDS.stp
board/ESP32-POE-ISO-master/ESP32-POE-ISO-master/HARDWARE/ESP32-PoE-ISO-Rev.C/3d/Cap_8x11_5x3_5mm.step
board/ESP32-POE-ISO-master/ESP32-POE-ISO-master/HARDWARE/ESP32-PoE-ISO-Rev.C/3d/Connector_1Port_RJ45_Magjack_10-100Base-T_AutoMDIX_PoE_Wurth_Electronics-7499211002A_DigiKey-732-4976-ND.step
board/ESP32-POE-ISO-master/ESP32-POE-ISO-master/HARDWARE/ESP32-PoE-ISO-Rev.C/3d/QFN-20_5x5x0_9mm.step
board/ESP32-POE-ISO-master/ESP32-POE-ISO-master/HARDWARE/ESP32-PoE-ISO-Rev.D/3d/Cap_8x11_5x3_5mm.step
board/ESP32-POE-ISO-master/ESP32-POE-ISO-master/HARDWARE/ESP32-PoE-ISO-Rev.D/3d/Connector_1Port_RJ45_Magjack_10-100Base-T_AutoMDIX_PoE_Wurth_Electronics-7499211002A_DigiKey-732-4976-ND.step
board/ESP32-POE-ISO-master/ESP32-POE-ISO-master/HARDWARE/ESP32-PoE-ISO-Rev.D/3d/QFN-20_5x5x0_9mm.step
board/ESP32-POE-ISO-master/ESP32-POE-ISO-master/HARDWARE/ESP32-PoE-ISO-Rev.G1/3d/Connector_1Port_RJ45_Magjack_10-100Base-T_AutoMDIX_PoE_Wurth_Electronics-7499211002A_DigiKey-732-4976-ND.step
board/ESP32-POE-ISO-master/ESP32-POE-ISO-master/HARDWARE/ESP32-PoE-ISO-Rev.H/3d/Connector_1Port_RJ45_Magjack_10-100Base-T_AutoMDIX_PoE_Wurth_Electronics-7499211002A_DigiKey-732-4976-ND.step
