HELP-TEC/MQTT_Keypad/Managment/Journal de travail.docx

# Journal de travail

Résumé des activités de Thbault Sampiemon au sein du Travail de master

Thibault Sampiemon | TM- Interface standardisée communication entre PLCs et carte embarquée| 21.02.2022

# Table des activités

Date | Nombre d’heures | Travail effectué | Efficacité autoévaluée (0-10)
21.02.22 | 8h | - Téléchargement des logiciel et bases de travail (ex : projet open source de carte de démonstration ESP32) - Entretien avec monsieur Mayer - Correction des planifications du projet suite à un entretien avec monsieur Mayer - Divers administratif d’entrée en fonction dans les locaux de St-Imier (ex :accès) - Découverte de la carte exemple sur KiCAD - Découverte de KiCAD | 5
22.02.22 | 7h | - TUTO KiCAD - Etude de disponibilité des composants - Changement et étude de possibilité des changements de plan (utilisation d’une carte toute faite pour les parties « standard » - Divers administratifs (accès suite et fin) - Recherche de composant de remplacement PoE avant les changements de plan | 5
24.02.22 | | - Choix composants carte fille et schémat block boutons poussoirs | 8->pour l’instant mdr
