HELP-TEC/MQTT_Keypad/Consception/CarteFilleBlockDiagram.drawio.pdf

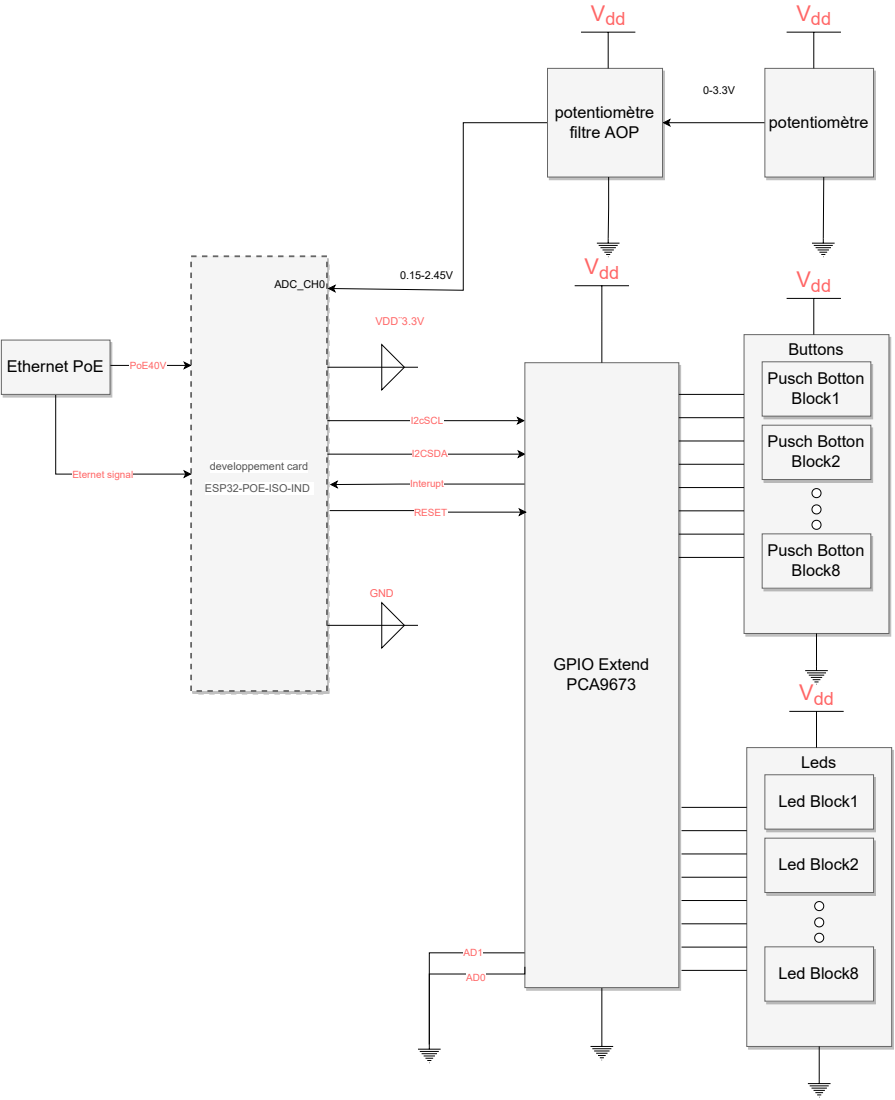
[picture p104: page 1]
Buttons; I2cSCL; I2CSDA; developpement card; ESP32-POE-ISO-IND; Interupt; GPIO Extend PCA9673; PoE40V; Eternet signal; Ethernet PoE; Vdd; VDD¨3.3V; GND; RESET; Pusch Botton Block2; Pusch Botton Block1; Pusch Botton Block8; Leds; Led Block2; Led Block1; Led Block8; potentiomètre potentiomètre filtre AOP; ADC_CH0
