HELP-TEC/MQTT_Keypad/programmes/programmes/Programe_ESP/tcp_try/main/adc_module.h

/**
 * @file adc_module.h
 * MQTT (over TCP)
 * @date 6.03.2022
 * Created on: 6 mai 2022
 * @author Thibault Sampiemon
 */
#ifndef ADC_MODULE_H_
#define ADC_MODULE_H_
void potentiometer_task(void *arg);
void potentiometer_config(void);
#endif /* ADC_MODULE_H_ */
