HELP-TEC/MQTT_Keypad/(commit log)

2022-02-22 etude PoE carte
    regarder les composant de la carte leurs fonctionnalités et étudier des altenative (sur plusieurs versions de carte car la dernière version comporte de composant non-disponibles)
    [BAT54.step, CD32_inductor.step, Cap_8x11_5x3_5mm.step, Cap_PTH_6_3x11x2_5mm.step, Connector_1Port_RJ45_Magjack_10-100Base-T_AutoMDIX_PoE_Wurth_Electronics-7499211002A_DigiKey-732-4976-ND.step, DO-214AB_SMC.step, DO-214AC_SMA.step, ESP32-PoE-ISO_Rev_B-BOM.ods]
2022-02-24 réorganisation du Git
    [BAT54.step, CD32_inductor.step, Cap_8x11_5x3_5mm.step, Cap_PTH_6_3x11x2_5mm.step, Connector_1Port_RJ45_Magjack_10-100Base-T_AutoMDIX_PoE_Wurth_Electronics-7499211002A_DigiKey-732-4976-ND.step, DO-214AB_SMC.step, DO-214AC_SMA.step, ESP32-PoE-ISO_Rev_B-BOM.ods]
2022-02-24 Coose of PCA9673
    as an interrupt output
2022-02-24 BlockdiagramCarteFilleDébut
    début du choix de composant et du blockdiagram de la carte fille
2022-03-08 reburth of git
    new commit after long time scêance de travaille st-imier
    [BAT54.step, C1608X5R1H104K080AA.step, CD32_inductor.step, Cap_8x11_5x3_5mm.step, Cap_PTH_6_3x11x2_5mm.step, Classeur1.xlsx, Connector_1Port_RJ45_Magjack_10-100Base-T_AutoMDIX_PoE_Wurth_Electronics-7499211002A_DigiKey-732-4976-ND.step, DO-214AB_SMC.step]
2022-03-10 backup avant rajout du driver led
    pour avoir la version sans driver led
    [cartteFille.kicad_sch]
2022-03-11 5V_to_3.3V
    Changement générale de tension du 5v au 3.3v
    tous les composant peuvent travailler sous les 2 tension les calcules de résistance... on été refais /cherché dans la doc... étonnement peux de changement ont été nécessaires
    [cartteFille.kicad_sch]
2022-03-14 end_sch
    fin du schéma électrique début du pcb
    [cartteFille.kicad_pcb, cartteFille.kicad_sch]
2022-03-14 push sous schémat
    [button.kicad_sch, cartteFille.kicad_pcb, cartteFille.kicad_sch]
2022-03-14 resistor tab adding
    on rajoute une table de résistance pour le changement facile de boutons
    [button.kicad_sch, cartteFille.kicad_pcb, cartteFille.kicad_sch]
2022-03-14 end of the day
    [button.kicad_sch, cartteFille.kicad_sch]
2022-03-14 improve schematic
    + replace AOP with a jellybean one (LM358)
    + better usage of master board pins
    + graphical improvements
    [button.kicad_sch, cartteFille.kicad_sch]
2022-03-15 litle change
    [button.kicad_sch, cartteFille.kicad_sch]
2022-03-15 commit sync
    [cartteFille.kicad_sch]
2022-03-15 commit début placage
    début du placage sans les bouttons
    [ESP32-PoE-ISO_Rev_H.kicad_pcb, cartteFille.kicad_pcb]
2022-03-15 placage de bouton approximatif
    tous les composant ont été placé approximativement à des places qui simplifie les connexion entre ceux-ci. Il faudra encore adapter le disign en fonction des dimensions exactes du pcb et des volonté de placement de l'entreprise. puis créer une version clean. pour le moment pcb de 80x100 et placage des bouton en 2 colonnes de 4 botons avec une parie réservée au potentiomètre
    [cartteFille.kicad_pcb]
2022-03-17 Boutton_spec_mecha_1_incomplete
    premier placement avant intégration du potentiomètre suite a la réception de la vue mécanique sans potentiomètre
    [cartteFille.kicad_pcb]
2022-03-21 pcb presque final
    Les trous de montages doivent être réajuster
    [button.kicad_sch, cartteFille.kicad_pcb, cartteFille.kicad_sch]
2022-03-21 final_V1.0_with_no_true_error
    version ou les erreurs et warning restant sont des exaction commise sciemment. Il faut encore reconfigurer le debug pour qu'il accepte ces erreurs ou refactor pour rester dans les clou (ex il n'aime pas notre superposition de l'emprunte de la résistance et celle du régulateur de courant).
    todo développeur:
    Repasser sur tous le pcb pour tous revérifier
    Voir comment faire avec le debug
    [cartteFille.kicad_pcb]
2022-03-22 Cangement Silkscreen pour JLCPCB
    JLCPCB veut un minimum de 1mmx1mm pour le texte dans les silkscreen j£ai donc augmenter et replacer les Labels de la couche silkscreen
    [cartteFille.kicad_pcb]
2022-03-29 New_pcb_with_PCA8
    #Tache effectuée :
    + remplacer et rerouter le gpio
    #TODO
    + refaire nomenclature
    + replacer silkscreen et fab
    + netoyer piste
    + executer debug
    + finitions
    [button.kicad_sch, cartteFille.kicad_pcb, cartteFille.kicad_sch]
2022-03-31 Review_GPIO_Replaced
    version avant la review du pcb avec les nouveau gpio
    [button.kicad_sch, cartteFille.kicad_pcb, cartteFille.kicad_sch]
2022-04-01 ficher gbr
    [cartteFille-B_Cu.gbr, cartteFille-B_Mask.gbr, cartteFille-B_Paste.gbr, cartteFille-B_Silkscreen.gbr, cartteFille-Edge_Cuts.gbr, cartteFille-F_Cu.gbr, cartteFille-F_Mask.gbr, cartteFille-F_Paste.gbr]
2022-06-11 commit_V2_PCB
    seciond version of pcb final version with gerbert fils
    ZIP of the gerber = gerbert_V2
    [button.kicad_sch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]
2022-08-10 python with 4 board
    add a client python with 4 board 2 with potentiometer and 2 without potentiometer
2022-09-29 Test SPIFFS (fail) + python script for MQTT config
    Test SPIFFS (fail) changement vers transmission UART.
    Ajout du script python (dev) (config_pannel) pour la configuration des cartes depuis un fichier json.
    [adc_module.c, app_main.c, config.h, config_pannel.py, mqtt_module.c]
2022-09-30 Correction de bug script python + avancement de l'interface
    [app_main.c, config.h, config_pannel.py, mqtt_module.c]
2022-10-03 Udpate python script + Storage on esp
    Lecture et écriture possible via le script python dans la nvs de l'esp32.
2022-10-05 Bug solved
    Transmission bug '\0' was missing in the end of frame
    [config_pannel.py]
2022-10-06 Reading config in esp nvs
    ESP needs reset to start MQTT communication
    [app_main.c, config.h, config_pannel.py, mqtt_module.c]
2022-10-06 Bug solved subscribtions after reset
    [mqtt_module.c]
2022-10-21 Bug solve on read config
    [config_pannel.py]
2022-11-15 Changes psw file for led panel and update config_pannel.exe
